miraclesystems-pe/Sistema-de-Coordenadas---Rover-Topografico/(commit log)

2026-11-08 código del sistema de coordenadas del rover
2026-11-08 Imagen de Conexiones
2026-11-14 Actualizacion de rover.ino y limpieza de archivos
